esmiyaki/ee463_project/README.md

# ee463_project

We are team CONVERTEROĞULLARI TİC. A.Ş. and as our term project for the course ee463, we are designing a controlled rectifier to drive a DC motor at 180 V using grid voltage
