esmiyaki/ee463_project/(commit log)

2025-11-27 rectifier simulation
    formed a comprehensive simulation focusing on the rectifier part of the circuit. the placeholder buck converter is placed to model a more realistic demand from the load. there is also a starter resistor and bypass circuitry that is not connected to the main model. it will probably be removed after further analysis and comparison when the remaining elements of the circuit are completed as well.
2025-11-29 initial rectifier combined with buck
    the initial circuitry is now combined with our own buck converter model. unnecessary parts from the previous simulation are removed and certain value adjustments are made.
2025-11-29 Control and Buck Converter Overall Diagram
    Control and Buck side overall diagram, including the isolation and feedback.
    Optocoupler
    Isolation Amplifier
    Arduino
2025-11-29 Buck Converter driver source code
    Switching frequency set to 31.25 kHz.
    Includes the feedback and soft start.
    Later, a speed control will be added.
2025-11-30 Test results of Gate Drive
    Test results of the gate drive algorithm made in Wokwi. Target output voltage (green), output voltage (orange), and duty cycle(purple).
2025-12-04 Buck Converter newest simulation version
